dMEK/Sumobot/README.md

# Sumobot
Yr 4 BEng Mechatronics project
*not 100% functional!
